biancagodoy45/Pass-Band-Filter/README.md

Second Homework for Electronics Course. UBB 02-2018
