biancagodoy45/Pass-Band-Filter/Kicad/Pass-Band Filter-brd.pdf

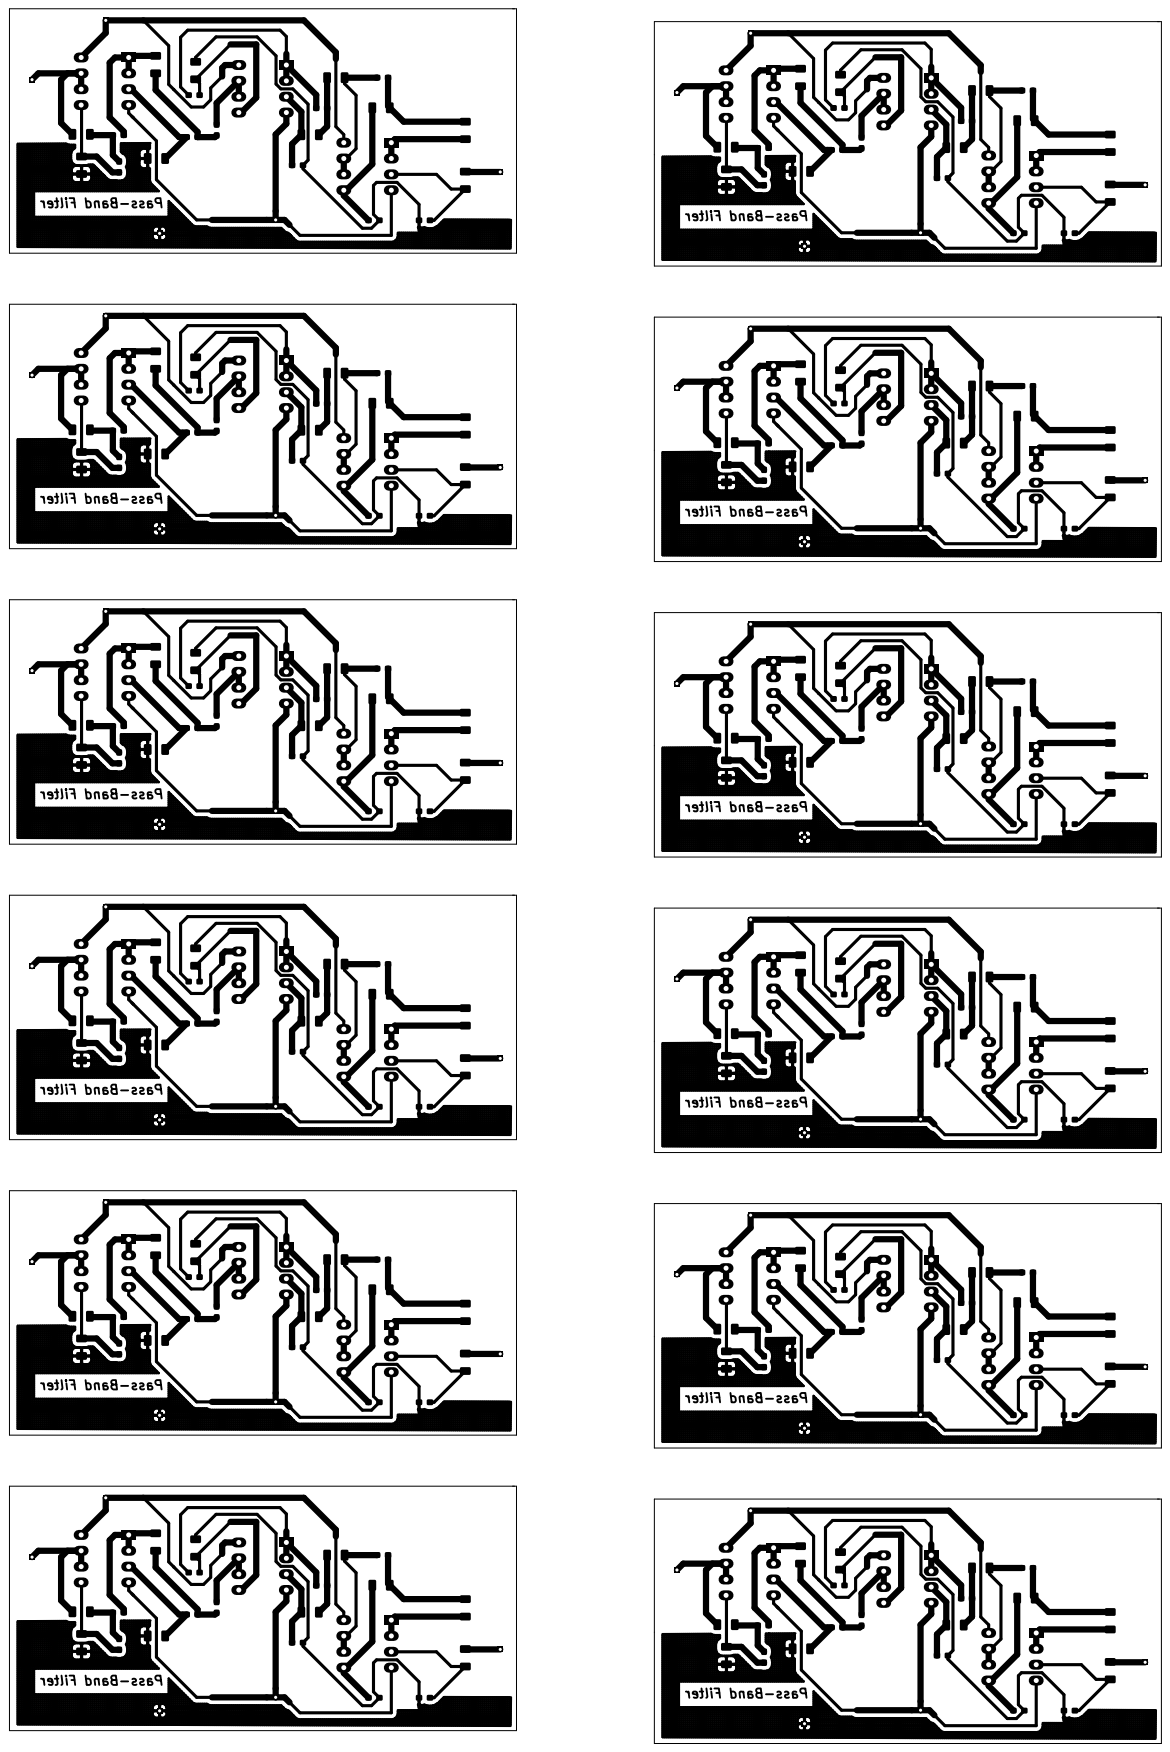
[picture p6: page 1]
