biancagodoy45/Pass-Band-Filter/Lt spice/Pass-band-filter.asc

C1: cap; 33n
C2: cap; 33n
C3: cap; 47n
C4: cap; 47n
C5: cap; 33n
C6: cap; 20n
C7: cap; 20n
C8: cap; 20n
C9: cap; 20n
C10: cap; 20n
R1: res; 1k
R2: res; 1k
R3: res; 1k
R4: res; 1k
R5: res; 1k
R6: res; 13k
R7: res; 16k
R8: res; 11k
R9: res; 3.9k
R10: res; 43k
U1: LM358
U2: LM358
U3: LM358
U4: LM358
U5: LM358
U6: LM358
V1: voltage; ""; AC 1
V2: voltage; 12
V3: voltage; 12
Named nets: 0, vcc, vee, Out
.ac dec 100 100 100k
