biancagodoy45/Pass-Band-Filter/Kicad/Pass-Band Filter.kicad_pcb

## KiCad design Kicad/Pass-Band Filter.kicad_pcb (2019-01-21)

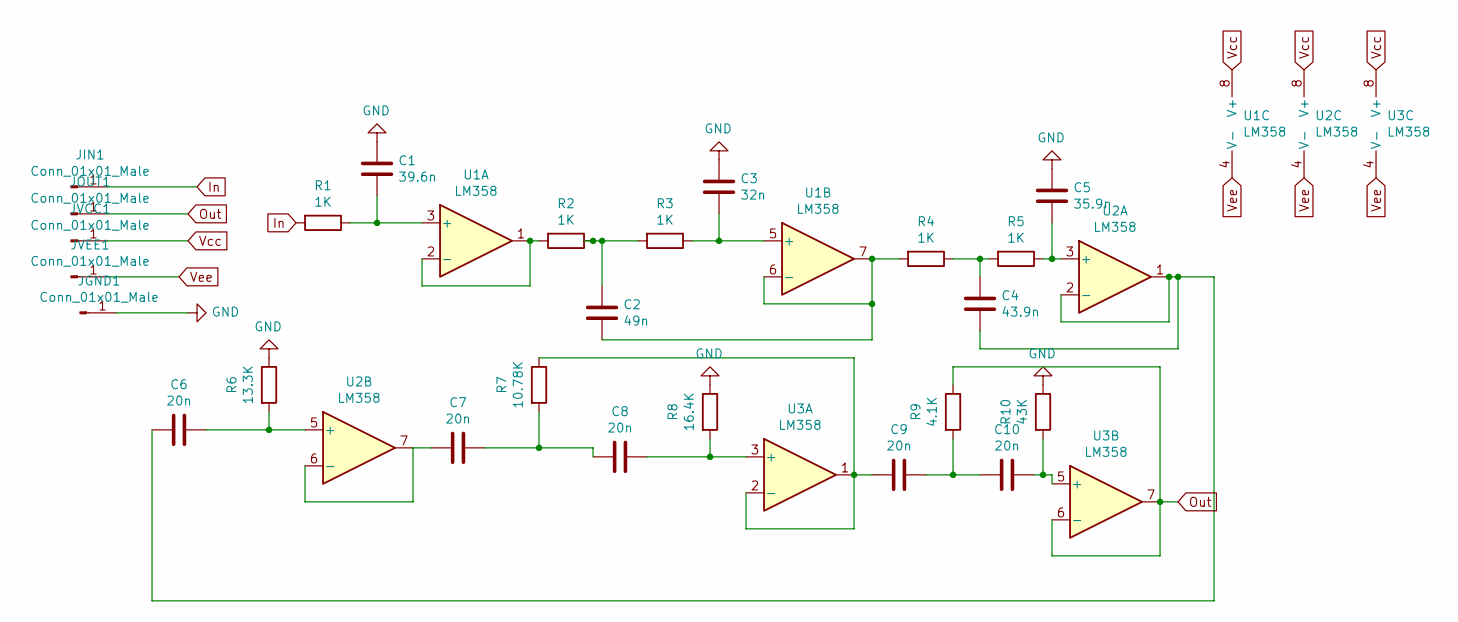
[picture p7: schematic Pass-Band Filter.sch]

Parts:
C1: 39.6n; C_0603_1608Metric_Pad1.05x0.95mm_HandSolder
C2: 49n; C_0603_1608Metric_Pad1.05x0.95mm_HandSolder
C3: 32n; C_0603_1608Metric_Pad1.05x0.95mm_HandSolder
C4: 43.9n; C_0603_1608Metric_Pad1.05x0.95mm_HandSolder
C5: 35.9n; C_0603_1608Metric_Pad1.05x0.95mm_HandSolder
C6, C7, C8, C9, C10: 20n; C_0603_1608Metric_Pad1.05x0.95mm_HandSolder
JGND1: Conn_01x01_Male; PinHeader_1x01_P1.00mm_Vertical
JIN1: Conn_01x01_Male; PinHeader_1x01_P1.00mm_Vertical
JOUT1: Conn_01x01_Male; PinHeader_1x01_P1.00mm_Vertical
JVCC1: Conn_01x01_Male; PinHeader_1x01_P1.00mm_Vertical
JVEE1: Conn_01x01_Male; PinHeader_1x01_P1.00mm_Vertical
R1, R2, R3, R4, R5: 1K; R_1206_3216Metric
R6: 13.3K; R_1206_3216Metric
R7: 10.78K; R_1206_3216Metric
R8: 16.4K; R_1206_3216Metric
R9: 4.1K; R_1206_3216Metric
R10: 43K; R_1206_3216Metric
U1, U2, U3: LM358; DIP-8_W7.62mm_Socket_LongPads

Connections:
GND: C1.1, C3.1, C5.1, JGND1.1, R6.1, R8.1, R10.1
In: JIN1.1, R1.2
unnamed: C1.2, R1.1, U1.3 (+)
unnamed: C2.1, R2.1, R3.2
unnamed: C2.2, R4.2, U1.6 (-), U1.7
unnamed: C3.2, R3.1, U1.5 (+)
unnamed: C4.1, R4.1, R5.2
unnamed: C4.2, C6.2, U2.1, U2.2 (-)
unnamed: C5.2, R5.1, U2.3 (+)
unnamed: C6.1, R6.2, U2.5 (+)
unnamed: C7.1, C8.2, R7.2
unnamed: C7.2, U2.6 (-), U2.7
unnamed: C8.1, R8.2, U3.3 (+)
unnamed: C9.2, R7.1, U3.1, U3.2 (-)
unnamed: C10.1, R10.2, U3.5 (+)
unnamed: C9.1, C10.2, R9.2
unnamed: R2.2, U1.1, U1.2 (-)
Out: JOUT1.1, R9.1, U3.6 (-), U3.7
Vcc: JVCC1.1, U1.8 (V+), U2.8 (V+), U3.8 (V+)
Vee: JVEE1.1, U1.4 (V-), U2.4 (V-), U3.4 (V-)

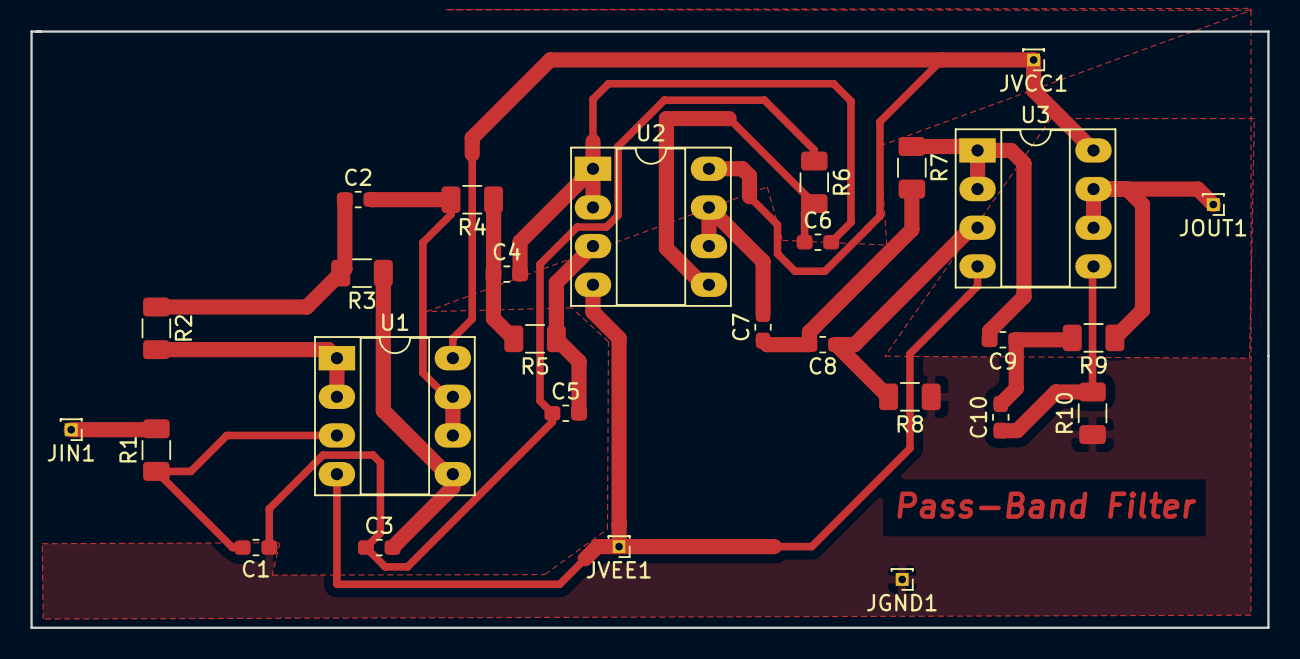
[picture p8: board Pass-Band Filter.kicad_pcb from above]

Board: 2 copper layers, 81.3 x 39.2 mm, 28 parts (0 on the bottom side), 20 nets.
